2058426331kkj-code/cw32-multimeter/标定操作说明.md

# 电压、电流按键标定说明

本次实现按原理图接线：K1=PB12，K2=PB13，K3=PB14，按下接地。
ADC序列0采PB10/IN11电压，序列1采PB11/IN12电流。
电压默认220kΩ:10kΩ分压，电流默认100mΩ（0.1Ω）采样电阻、无额外放大器。

## 标定模式与操作

|模式|上排显示|下排显示|K2的作用|
|---|---|---|---|
|0|实际电压|实际电流|无操作|
|1|S05|当前电压|记录5.00V时的滤波ADC码|
|2|S15|当前电压|记录15.00V时的滤波ADC码|
|3|A0.5|当前电流|记录0.50A时的滤波ADC码|
|4|A1.5|当前电流|记录1.50A时的滤波ADC码|

七段管S与数字5形状相同，S05看起来接近505；小数点不额外占一位。

- K1每按一次：0→1→2→3→4→0。
- K2在模式1～4记录当前输入并保存Flash，成功后自动回模式0。
- K3立即返回模式0，不保存当前输入。
- 连续按下100ms才确认，长按只触发一次；松开20ms后才允许再次触发。
- 同时按键时K3优先，其次K1，防止误保存。

推荐依次操作：
1. 用万用表确认输入5.00V，等待读数稳定；进入模式1，按K2保存。
2. 将输入调到15.00V并用万用表确认；从模式0按两次K1进入模式2，按K2保存。
3. 用标准电流表确认电流0.50A；从模式0按三次K1进入模式3，按K2保存。
4. 将电流调到1.50A；从模式0按四次K1进入模式4，按K2保存。
5. 回到模式0检查几个中间值，再断电重启确认参数保持。

标定值应由外部仪表确认，不要根据本机尚未校准的显示调节输入。
每路只有一个实测点时，该点会保存，但该路仍采用理论换算；两个实测点齐全后才启用该路拟合。
因此记录第一个点后，显示值不一定立刻变为该标定值，这是预期行为。

## 数学原理与单位

- Volt_Buffer、Curr_Buffer：最近20次ADC原始码，范围0～4095。
- X05、X15：在5V、15V下记录的电压通道ADC码。
- IX05、IX15：在0.5A、1.5A下记录的电流通道ADC码。
- V_Buffer：实际电压的100倍，单位0.01V。
- I_Buffer：实际电流的100倍，单位0.01A。

电压：K=(1500-500)/(X15-X05)，b=500-K*X05，V_Buffer=K*ADC码+b。
电流：KI=(150-50)/(IX15-IX05)，bi=50-KI*IX05，I_Buffer=KI*ADC码+bi。
结果四舍五入为整数；负值归零，并按三位显示范围上限限幅。
小于10时显示x.xx，10及以上显示xx.x，例如12.34V显示12.3。

参考截图称“三点标定”，但实际五种模式只提供两个非零点，没有采集0V/0A的步骤。
本实现是每路两点直线校准，同时修正斜率和偏移；不能声称独立完成了零点标定。
可以用0V/0A检查剩余零点误差，但不要在5V/15V/0.5A/1.5A模式下把零输入存为标定点。

## 代码位置与执行顺序

- GPIO.c / GPIO.h：按键引脚初始化，1ms消抖，按键事件的原子读取。
- TIM.c：每1ms读取两路ADC、扫描按键、扫描一位数码管。这里不擦写Flash。
- ADC.c：20点去极值平均；Volt_Cal调用标定模型进行换算。
- Calibration.c / Calibration.h：模式状态机、参数校验、ComputeK、保存和读取、误差提示。
- Seg_Display.c：模式标签、当前读数和错误码；六位段码一起更新。
- User/main.c：上电读取参数；主循环响应按键，每300ms更新测量值。
- 工程模板.uvprojx：已添加Calibration.c/h，并将代码ROM大小限制为0xFC00。

中断只发送事件，主循环处理标定与Flash操作。标定不另设BrushFlag/timecount，
而是复用现有GetTick毫秒计时和显示更新机制，避免两套计时混用。

## Flash保存策略

CW32F030C8配置为64KB Flash，每页512字节。
链接代码区为0x0000～0xFBFF，以下两页专门保存参数：
- 页126：0xFC00～0xFDFF。
- 页127：0xFE00～0xFFFF。

记录包含版本、递增序号、有效点掩码、四个ADC码、校验值、最后写入的提交标记。
每次先擦写另一页，新记录验证成功后才替代旧记录，旧页此时仍保留。
上电检查两个记录，采用校验有效且序号最新的一份；都无效时采用理论系数。
保存期间短暂关闭位选和中断，恢复后继续扫描；不在每300ms刷新时自动保存。

普通断电会保留Flash参数。重新烧录时若执行全片擦除，参数会清空，需要重新标定；
预留链接区只保证程序不占用这两页，并不阻止下载器的全片擦除功能。

## 错误提示

|下排错误码|含义|处理|
|---|---|---|
|E01|尚未取得完整20点采样|稍等后重新按K2|
|E02|标定码为0、超范围、点序反向或间隔过小|确认输入及模式，必要时重新标定该路两点|
|E03|Flash擦写或回读验证失败|旧参数保留；检查供电、写保护，重新按K2|

失败时留在当前模式，错误提示保持至下一次按键。
已经验证编译与主机模拟逻辑；尚未实际烧录开发板，Flash掉电行为与测量精度仍需上板验证。

## 本板电压分段补偿

根据本板与外部万用表的对比读数，在 `Calibration.c` 的 `CompensateVoltage()` 中加入以下补偿。区间按**补偿前的板子读数**划分，单位为 V；区间左端包含、右端不包含。

| 补偿前读数 | 加上补偿量 |
| --- | --- |
| 恰好为 0 | 0，保持零显示 |
| 大于 0 且小于 2 | 0.04 |
| 2 至小于 4 | 0.05 |
| 4 至小于 5 | 0.06 |
| 5 至小于 6 | 0.07 |
| 6 至小于 8 | 0.08 |
| 8 至 11 | 0.10 |
| 大于 11 | 0.10，按要求延用，尚未实测验证 |

例如原读数 1.50、3.00、4.50、5.50、7.00、9.00 V，修正后的内部值分别为 1.54、3.05、4.56、5.57、7.08、9.10 V。代码以 0.01 V 为单位，所以补偿常数为 4、5、6、7、8、10。

执行顺序是：ADC采样 → 去极值平均 → 原有电压换算 → 本表补偿 → 数码管格式化。正常模式及 S05/S15 模式使用同一份补偿结果；电流不变。每次处理新的换算值，不在上一次显示值上累加。K2仍保存原始ADC码，Flash记录格式不变。

这次严格采用分段常量，边界补偿会增加0.01～0.02 V，非零的极小读数也会增加0.04 V；保持零显示只针对换算结果恰好为零，不是新增零点消抖。若需连续过渡，应补测边界附近的成对读数后再拟合。

三位数码管在10 V及以上显示步进为0.1 V，内部仍按0.01 V计算；例如内部10.08 V最终显示10.1 V。显示位数和补偿表均不能证明实际测量精度。

目前辅助模块调到上限时，外部万用表实测约10.98 V，用户未使用15 V外部电源，因此尚未确认有效的15 V实测标定点。这次补偿保留现有标定参数，不会自动修复误存的标定点。若后续重新完成5.00 V和15.00 V标定，需重新核对本表残余偏差，避免叠加过度修正；按K2时应以外部参考万用表读数为准。

补偿已写入源码，需要重新编译并下载固件才能在板上生效。若下载器执行全片擦除，原Flash标定参数会丢失，原先测得的误差表也需重新核对。本次软件验证不代替上板实测。
