2058426331kkj-code/cw32-multimeter/(list of files, drawings)

Other design files:
Hardware/Altium_万用表_2026-10-29/万用表/Board1.PrjPcb
Hardware/Altium_万用表_2026-10-29/万用表/Board1/PCB1.pcbdoc
Hardware/Altium_万用表_2026-10-29/万用表/Board1/Schematic1/P1.schdoc
