2058426331kkj-code/cw32-multimeter/(commit log)

2026-10-29 Initial commit: CW32 multimeter firmware and calibration
2026-10-29 Add Altium hardware design and Chinese project introduction
    [Board1.PrjPcb, P1.schdoc, PCB1.pcbdoc]
2026-11-10 Add measured voltage compensation and document correction ranges
    [Calibration.c]
